spaelectronics/8CH-AC-Dimmer/README.md

# 8CH-AC-Dimmer
8 Channel A/C Dimmer w/Zero Cross Detection. Designed for use with Christmas Lights. Works with Vixen V2.
