spaelectronics/8CH-AC-Dimmer/Schematics.pdf

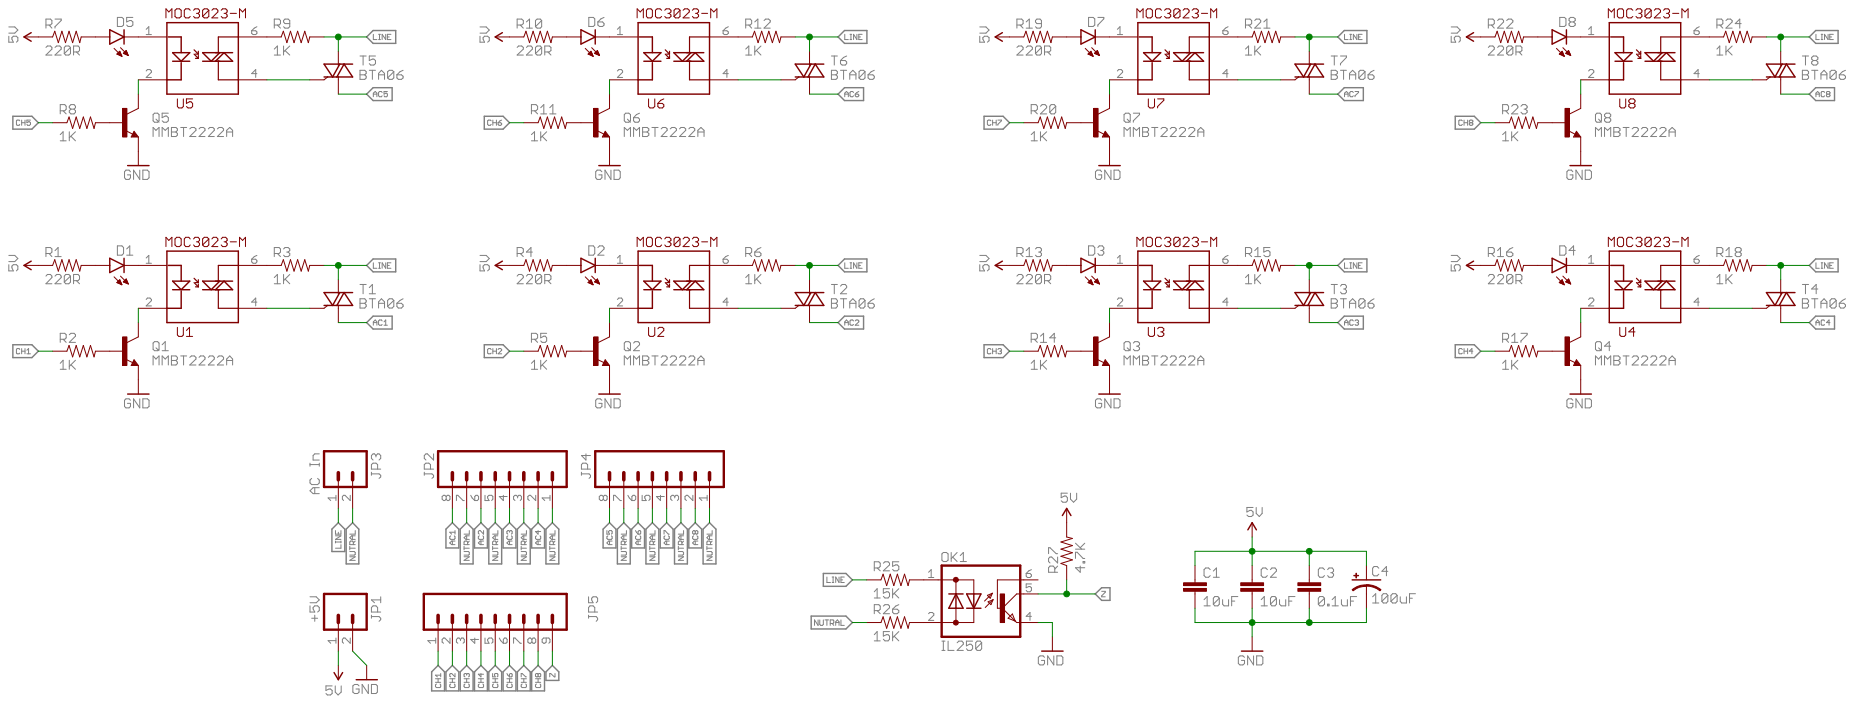
[picture p1: page 1]
