spaelectronics/8CH-AC-Dimmer/Eagle Files/8CH Dimmer.brd

## EAGLE design Eagle Files/8CH Dimmer.brd (2018-09-07)

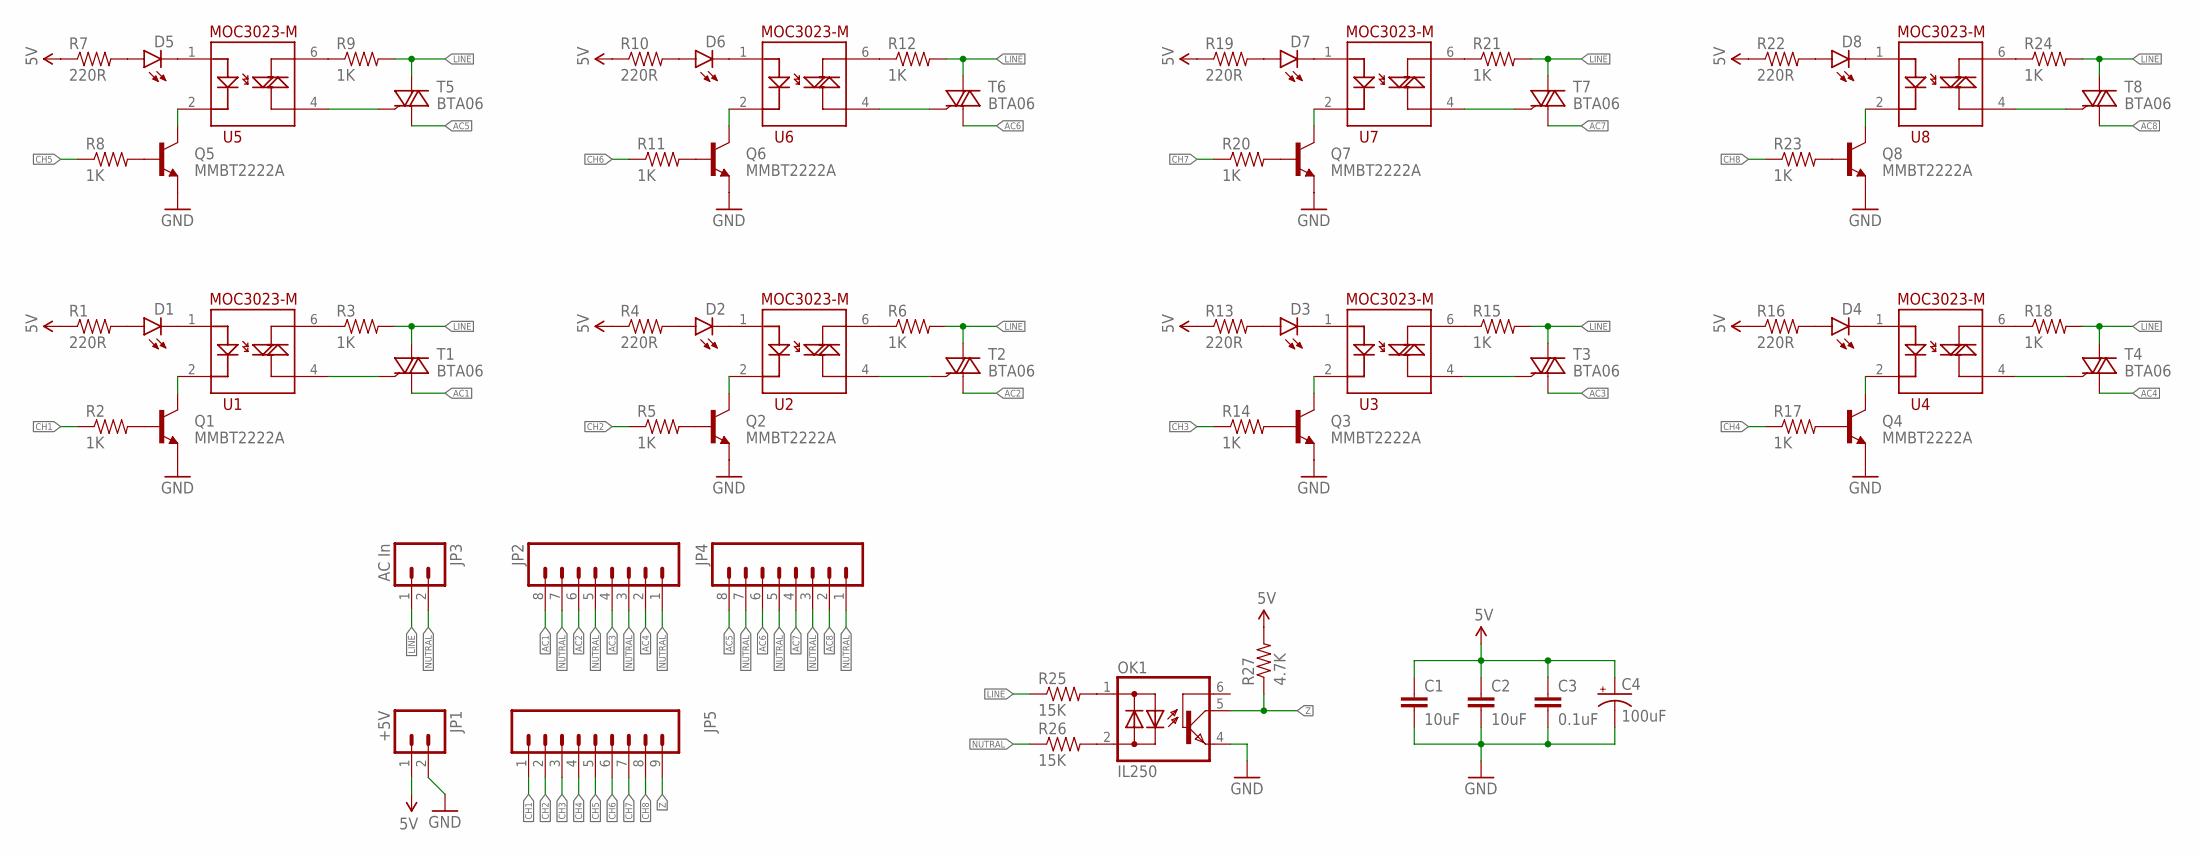
[picture p2: schematic 8CH Dimmer.sch]

Parts:
C1, C2: 10uF; 0805
C3: 0.1uF; 0805
C4: 100uF; E2,5-5
D1, D2, D3, D4, D5, D6, D7, D8: LED3MM
JP1: +5V; SCREWTERMINAL-3.5MM-2
JP2, JP4: M083.5MM-8; SCREWTERMINAL-3.5MM-8
JP3: AC In; SCREWTERMINAL-3.5MM-2
JP5: M09; 1X09
OK1: IL250; DIL06
Q1, Q2, Q3, Q4, Q5, Q6, Q7, Q8: MMBT2222A; SOT23-3
R1, R4, R7, R10, R13, R16, R19, R22: 220R; 0805
R2, R5, R8, R11, R14, R17, R20, R23: 1K; 0805
R3, R6, R9, R12, R15, R18, R21, R24: 1K; AXIAL-0.5
R25, R26: 15K; AXIAL-0.5
R27: 4.7K; 0805
T1, T2, T3, T4, T5, T6, T7, T8: BTA06; TO220-V
U1, U2, U3, U4, U5, U6, U7, U8: MOC3023-M; DIL06

Connections:
5V: C1.1, C2.1, C3.1, C4.+, JP1.1, R1.1, R4.1, R7.1, R10.1, R13.1, R16.1, R19.1, R22.1, R27.2
AC1: JP2.8, T1.1 (A1)
AC2: JP2.6, T2.1 (A1)
AC3: JP2.4, T3.1 (A1)
AC4: JP2.2, T4.1 (A1)
AC5: JP4.8, T5.1 (A1)
AC6: JP4.6, T6.1 (A1)
AC7: JP4.4, T7.1 (A1)
AC8: JP4.2, T8.1 (A1)
CH1: JP5.1, R2.1
CH2: JP5.2, R5.1
CH3: JP5.3, R14.1
CH4: JP5.4, R17.1
CH5: JP5.5, R8.1
CH6: JP5.6, R11.1
CH7: JP5.7, R20.1
CH8: JP5.8, R23.1
GND: C1.2, C2.2, C3.2, C4.-, JP1.2, OK1.4 (E), Q1.2 (E), Q2.2 (E), Q3.2 (E), Q4.2 (E), Q5.2 (E), Q6.2 (E), Q7.2 (E), Q8.2 (E)
LINE: JP3.1, R3.P$2 (2), R6.P$2 (2), R9.P$2 (2), R12.P$2 (2), R15.P$2 (2), R18.P$2 (2), R21.P$2 (2), R24.P$2 (2), R25.P$1 (1), T1.2 (A2), T2.2 (A2), T3.2 (A2), T4.2 (A2), T5.2 (A2), T6.2 (A2), T7.2 (A2), T8.2 (A2)
unnamed: D1.K (C), U1.1
unnamed: D1.A, R1.2
unnamed: Q1.1 (B), R2.2
unnamed: T1.3 (G), U1.4
unnamed: Q1.3 (C), U1.2
unnamed: R3.P$1 (1), U1.6
unnamed: Q2.1 (B), R5.2
unnamed: T2.3 (G), U2.4
unnamed: R6.P$1 (1), U2.6
unnamed: Q2.3 (C), U2.2
unnamed: D2.K (C), U2.1
unnamed: D2.A, R4.2
unnamed: Q5.1 (B), R8.2
unnamed: T5.3 (G), U5.4
unnamed: R9.P$1 (1), U5.6
unnamed: Q5.3 (C), U5.2
unnamed: D5.K (C), U5.1
unnamed: D5.A, R7.2
unnamed: Q6.1 (B), R11.2
unnamed: T6.3 (G), U6.4
unnamed: R12.P$1 (1), U6.6
unnamed: Q6.3 (C), U6.2
unnamed: D6.K (C), U6.1
unnamed: D6.A, R10.2
unnamed: Q3.1 (B), R14.2
unnamed: T3.3 (G), U3.4
unnamed: R15.P$1 (1), U3.6
unnamed: Q3.3 (C), U3.2
unnamed: D3.K (C), U3.1
unnamed: D3.A, R13.2
unnamed: Q4.1 (B), R17.2
unnamed: T4.3 (G), U4.4
unnamed: R18.P$1 (1), U4.6
unnamed: Q4.3 (C), U4.2
unnamed: D4.K (C), U4.1
unnamed: D4.A, R16.2
unnamed: Q7.1 (B), R20.2
unnamed: T7.3 (G), U7.4
unnamed: R21.P$1 (1), U7.6
unnamed: Q7.3 (C), U7.2
unnamed: D7.K (C), U7.1
unnamed: D7.A, R19.2
unnamed: Q8.1 (B), R23.2
unnamed: T8.3 (G), U8.4
unnamed: R24.P$1 (1), U8.6
unnamed: Q8.3 (C), U8.2
unnamed: D8.K (C), U8.1
unnamed: D8.A, R22.2
unnamed: OK1.1 (AC1), R25.P$2 (2)
unnamed: OK1.2 (AC2), R26.P$2 (2)
NUTRAL: JP2.1, JP2.3, JP2.5, JP2.7, JP3.2, JP4.1, JP4.3, JP4.5, JP4.7, R26.P$1 (1)
Z: JP5.9, OK1.5 (C), R27.1

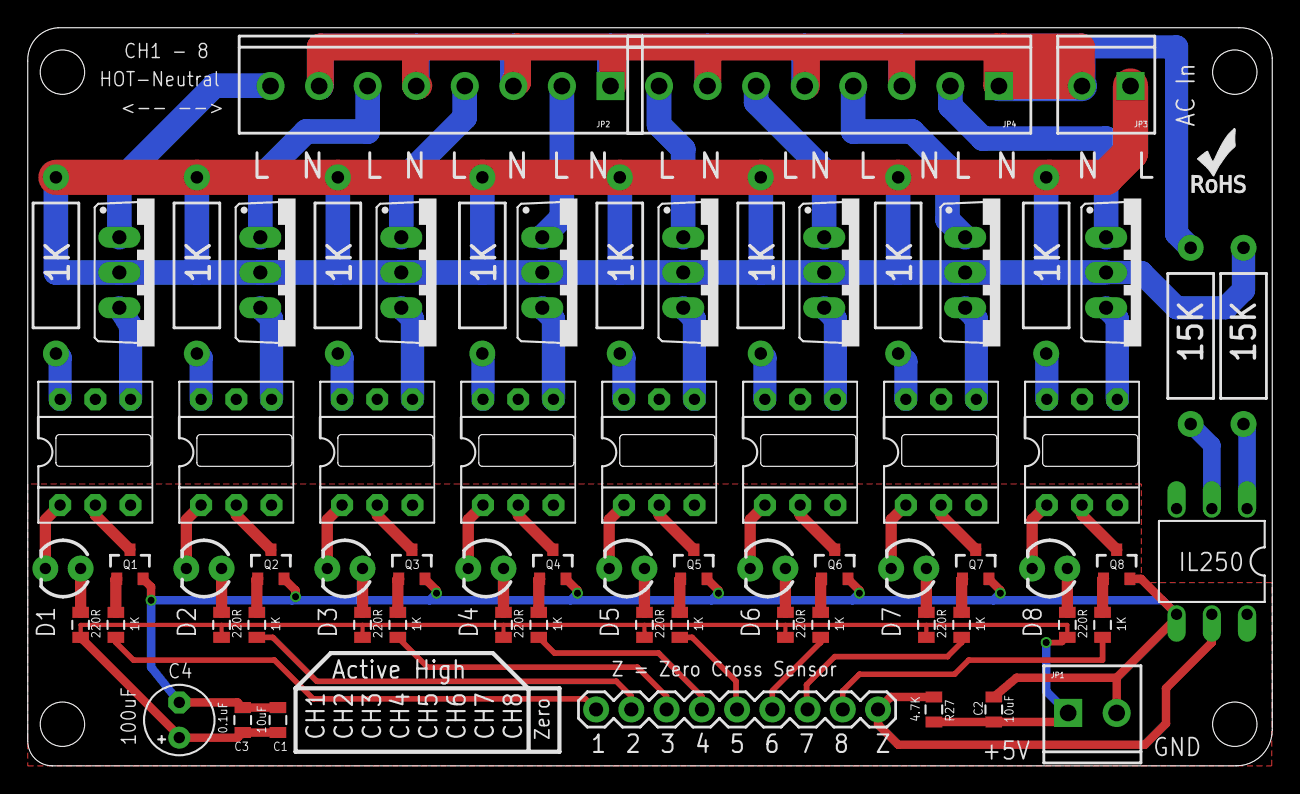
[picture p3: board 8CH Dimmer.brd from above]

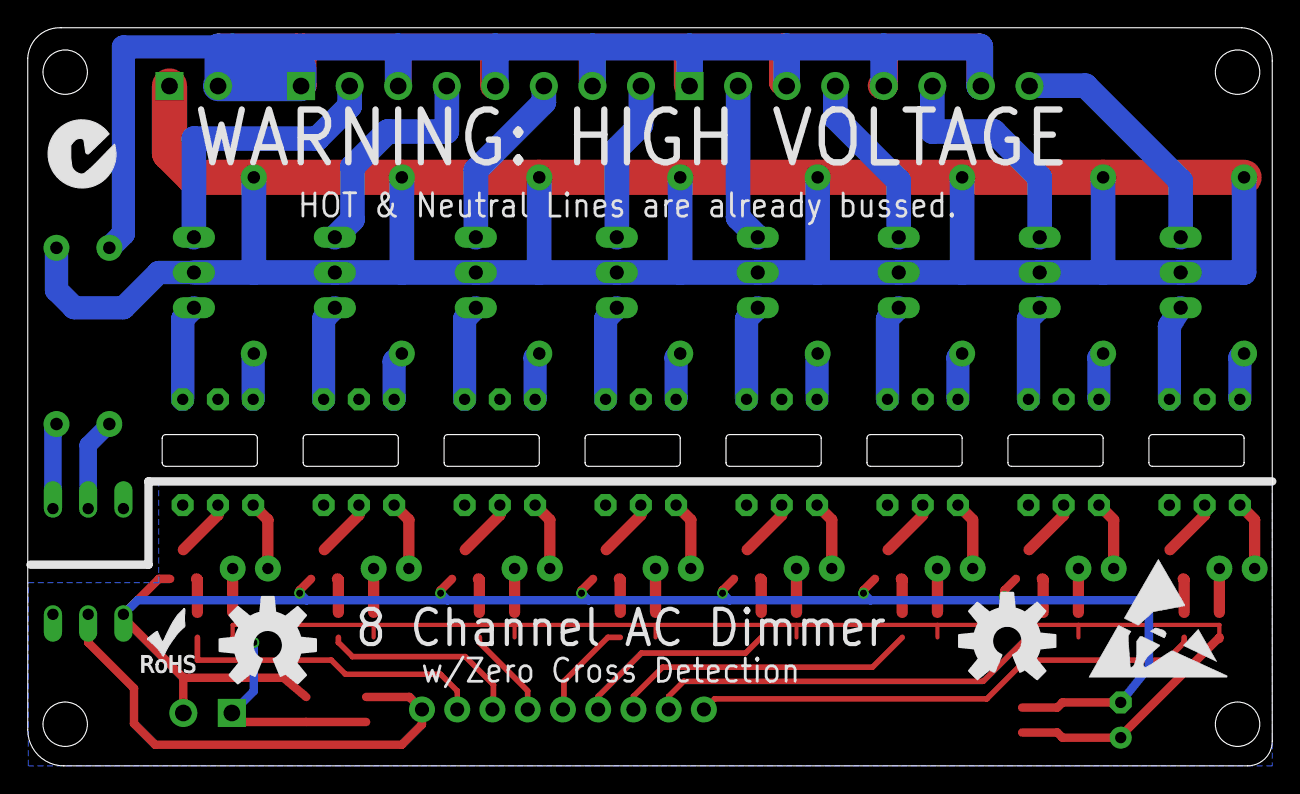
[picture p4: board 8CH Dimmer.brd from below]

Board: 2 copper layers, 89.7 x 53.2 mm, 75 parts (5 on the bottom side), 71 nets.

Other parts of the board:
U$1, U$2: OSHW-LOGO-L
U$3, U$4: ROHS_LOGO_0.18_IN
U$5: C_TICK-5MM
U$6: ESD_10.00
