spaelectronics/8CH-AC-Dimmer/Wiring_Diagram.png

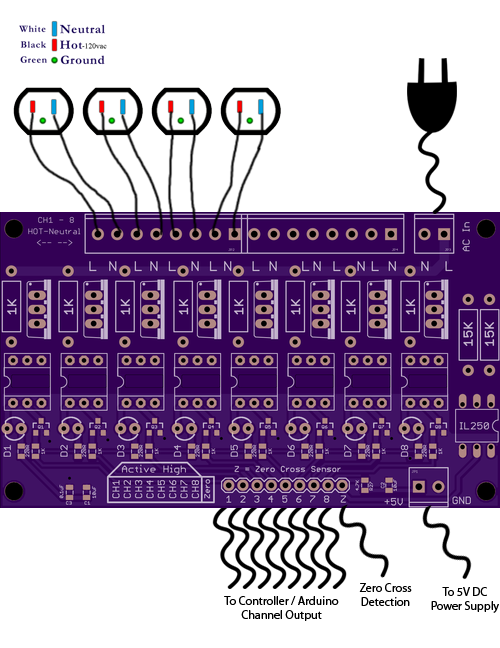
Wiring_Diagram.png
