spaelectronics/8CH-AC-Dimmer/(threads)

Thread 1 (2019-07-09):

XmasLightControllerForVixenSSRs will not compile

Simontho001, 2019-07-09:
when i try to upload the code to my arduino mega 2560 i get the error

> exit status 1
'power_usart3_disable' was not declared in this scope
how do i fix this will i need a library be cause i did install a library called avr/power.h but are there other ones that i need?

spaelectronics, 2019-07-10:
Try using a older version of Arduino IDE.
I can't remember which version I used to test, or else I would tell you which version to use.

Simontho001, 2019-07-10:
That seamed to fix it. Looked at some other threads about the error code it gave and said that you should use 1.6.9 so that seams go be the one that works best

spaelectronics, 2019-07-10:
That's good! Thanks for the update!

Closed 2019-07-10.

Thread 2 (2019-07-11):

how to set up serial communications

Simontho001, 2019-07-11:
i have plugged in the FT232R breakout board which i think is needed for it to work with vixen but i cant seem to make it work what is the wiring diagram for this? what settings do i need for vixen?

spaelectronics, 2019-07-11:
This is designed to be used with an Arduino or other microcontroller.
Most Arduino's have a built-in FTDI chip, so I am not understanding what your trying to do.

Can you provide a example of your circuit? or take a picture?

Simontho001, 2019-07-11:
Well I have been trying to use this board to get the data from vixen to the arduino mega ad that’s what I think the code and video is trying to tell me [This is what the writing looks like](https://images.app.goo.gl/mM2fupZdM42FhS11A)

spaelectronics, 2019-07-12:
Oh I get what your saying now.

Honestly, the last time I used this code was so long ago I really don't remember what settings I used anymore.

Unfortunately, I don't think I can be of much help.

Simontho001, 2019-07-19:
ok i found out how to make it work you need all 32 channels for your elements and patch them to the controller or just the same number as there are outputs then you set it to the port of the ftdi chip at 57600 baud rate with text header STRT and footer END
